SarwanShah/HU_2019_Tilt-Stablization-Control-System/Arduino Code/Final-Report.pdf

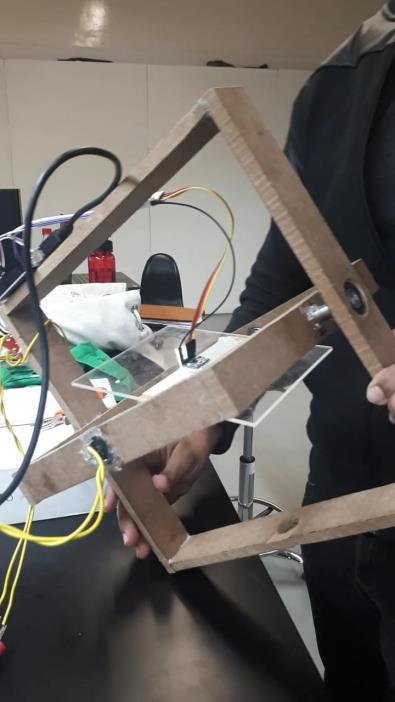
[picture p10: figure]
